RReinosa/RCK/Budget.xlsx

Presupuesto RCK v1.0
Item | Nombre | Tipo | Cantidad (min) | Pack | Precio total | Referencias
Condensadores | C_1206_3216Metric | 0.1uF | 9 | 16 | 3.78 € | https://es.aliexpress.com/item/32785228491.html
 |  | 1uF | 2 | 16
 |  | 10uF | 2 | 16
 |  | 22pF | 4 | 16
Resistencias | R_1206_3216Metric | 22 Ω | 8 | 20 | 4.23 € | https://es.aliexpress.com/item/32774150552.html
 |  | 10k Ω | 4 | 20
 |  | 330 Ω | 2 | 20
Diodos ghosting | D_SOD-123 | 1N4148W | 99 | 100 | 2.88 € | https://es.aliexpress.com/item/1005002887019519.html
Diodos Leds | LED_SK6812_PLCC4_5.0X5.0mm_P3.2mm | SK6812_RBGCW | 99 | 100 | 13.28 € | https://es.aliexpress.com/item/32641663497.html
Tornillos Pad | MountinHole_2.2mm_M2_Pad_Via | M2 | 14 | 14 | 0.52 € | PASTOR
Insertos tornillos | MountinHole_2.2mm_M2_Pad_Via | M2 | 14 | 14 | 0.46 € | PASTOR
USB-C | USB_C_Receptable_HRO_TYPE-C | 31-M-12 | 2 | 2 | 0.37 € | PASTOR
Polyfuse | Fuse_1206_3216Metric | 500mA | 2 | 2 | 0.14 € | PASTOR
Multiplex | CD74HC4067M | SOIC24 | 1 | 1 | 0.67 € | PASTOR
MCU | Atmega | 32U4-AU | 2 | 2 | 16.27 € | https://es.aliexpress.com/item/1005004179459191.html
Cristal | Crystal_SMD_HC49-SD | 16MHz | 2 | 2 | 0.47 € | PASTOR
Switches | Switch MX RGB Black | Gateron | 99 | 110 | 30.14 € | https://es.aliexpress.com/item/32980039972.html
Estabilizadores | EG_GH60 | 2 un. | 4 | 4 | 12.55 € | https://es.aliexpress.com/item/4000268680880.html
 |  | 6,25 un. | 1 | 1
PCB | FR-4_2Layers RCK v0.1 | Blue | 1 | 5 | 6.50 € | https://jlcpcb.com/
 | FR-4_2Layers RCK v1.0 | Blue | 1 | 5 | 38.94 €
Plate |  |  | 1
Caja |  |  | 1
Keycaps |  |  | 99
Cable | Cable en espiral | Black | 1 | 1 | 12.22 € | https://es.aliexpress.com/item/1005004438383771.html
 |  |  |  | Total | 143.42 €
 |  |  |  |  | 143.42 €
