RReinosa/RCK/v1.0/plate/Platecopia.DXF

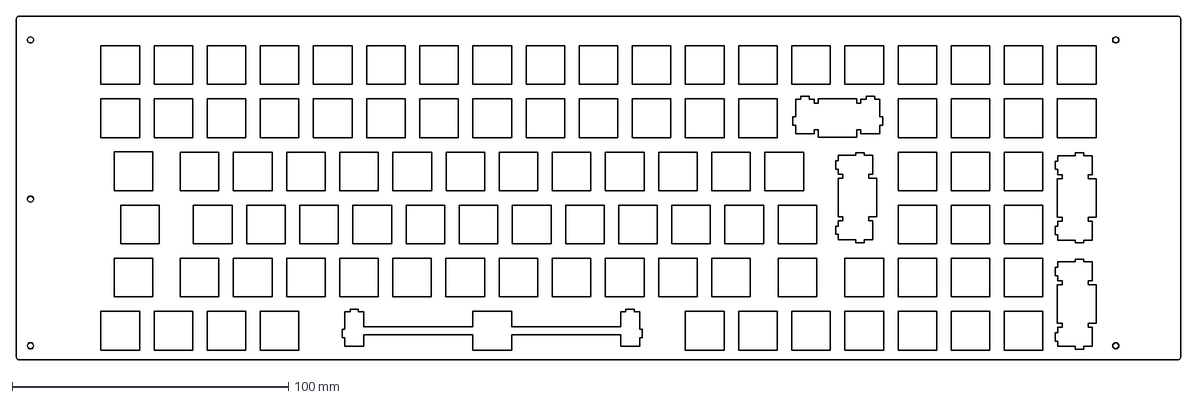
[picture p2: CAD file, 2023-10-01]
v1.0/plate/Platecopia.DXF
421.7 x 124.5 mm
