RReinosa/RCK/v1.0/plate/plate.dxf

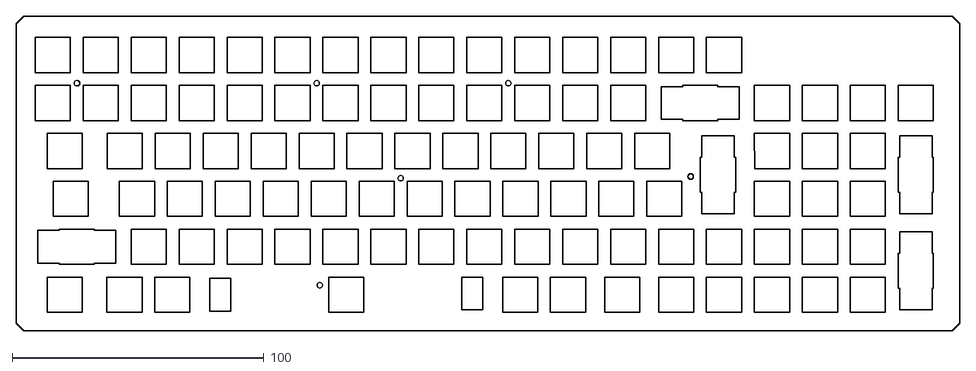
[picture p3: CAD file, 2023-03-14]
v1.0/plate/plate.dxf
375.0 x 125.0
