RReinosa/RCK/(list of files, cad)

Other CAD files:
v1.0/pcb/pcb.dxf
v1.0/plate/plate.dwg
