RReinosa/RCK/v1.0/pcb/pcb_design/pcb.pdf

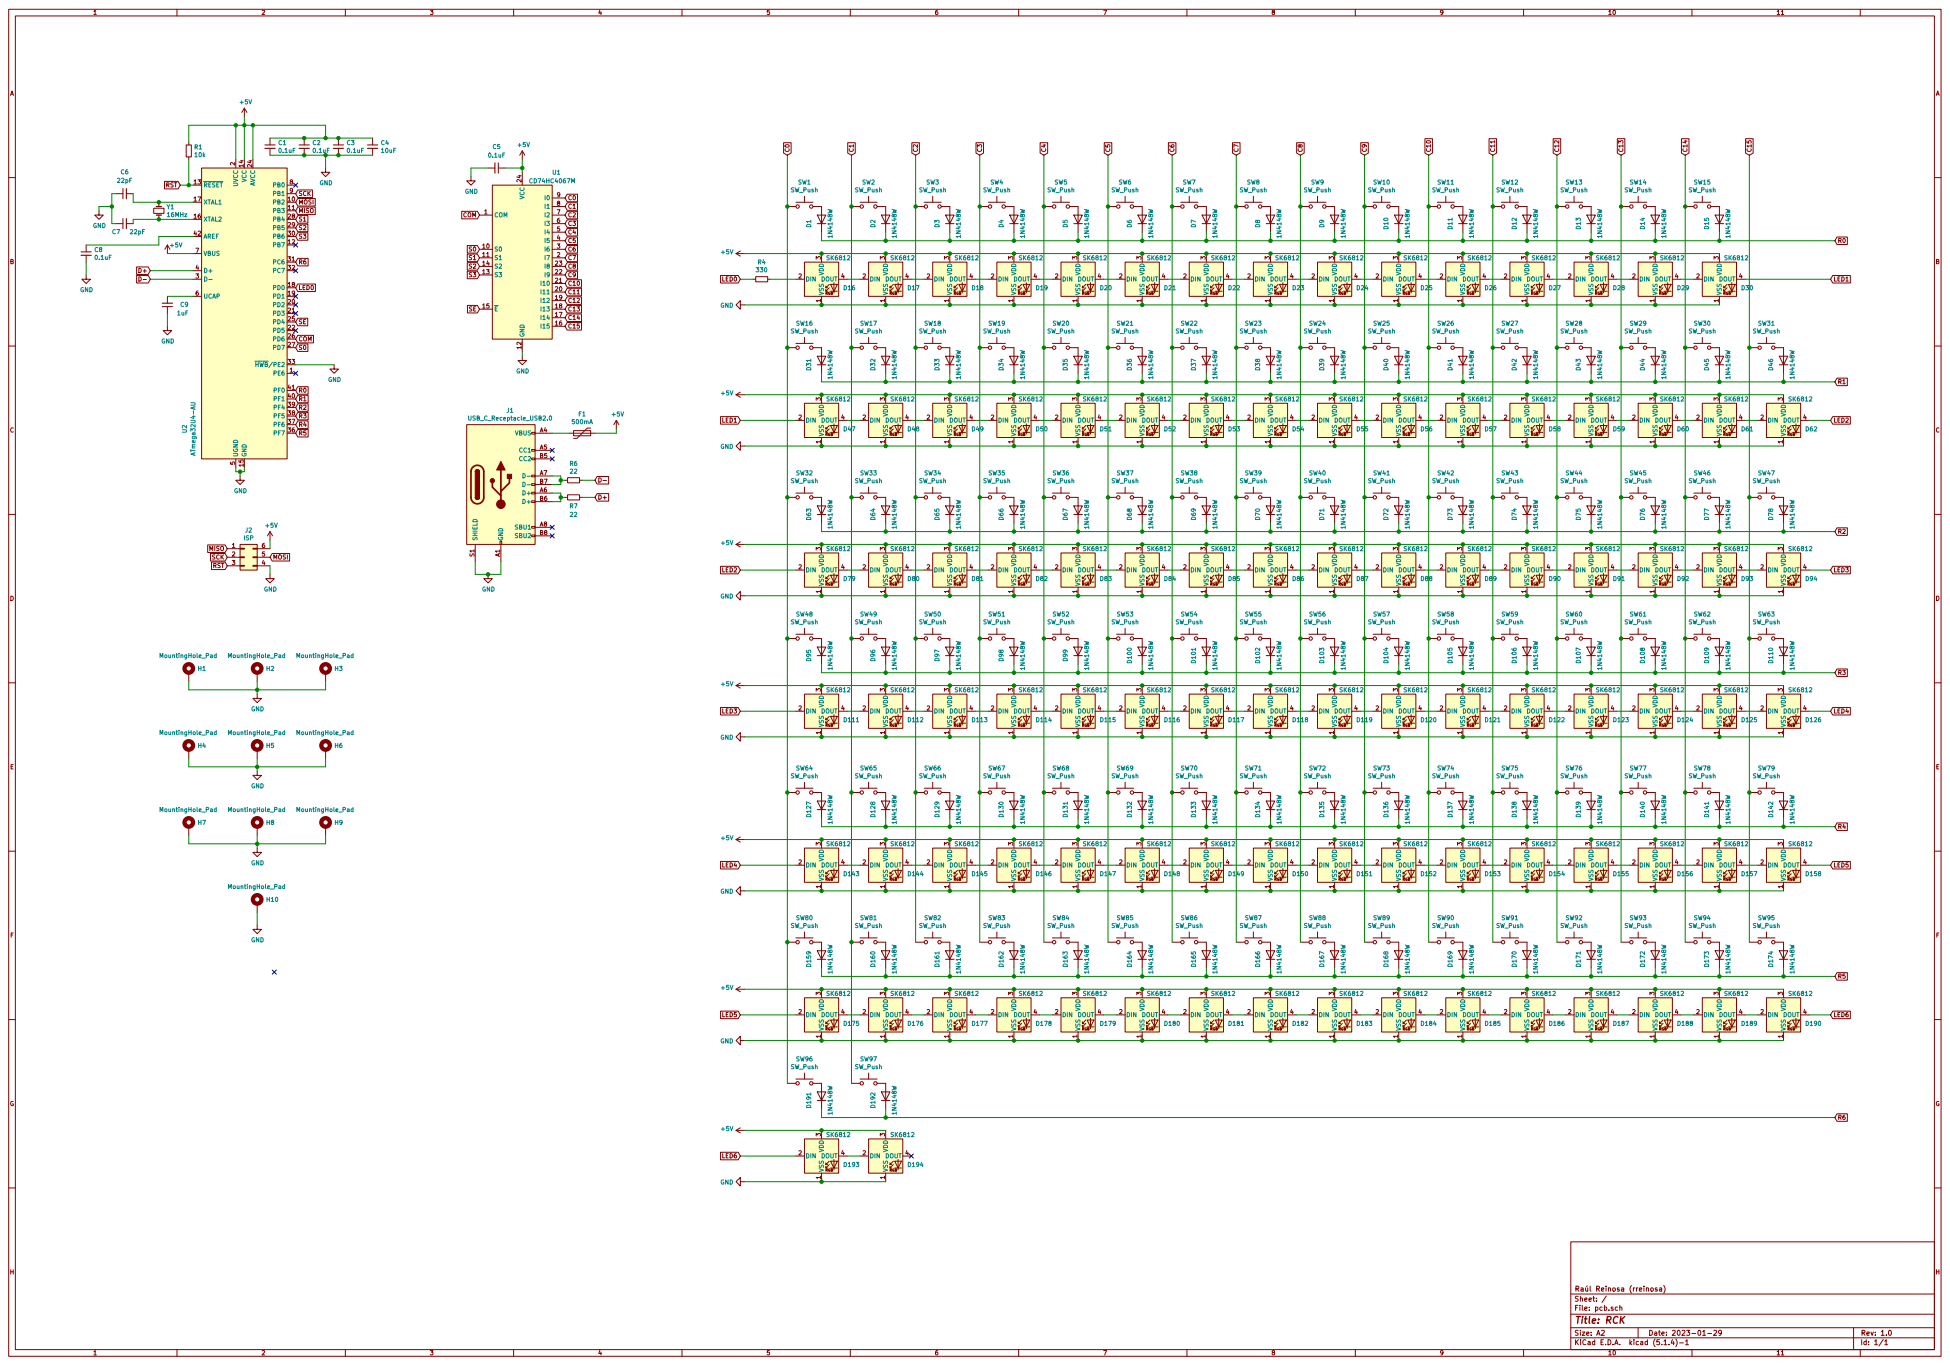
[picture p4: page 1]

2 PD2 20 PD3 21 PD5 22 AVCC 24 PD4 25 PD6 26 PD7 27 PB4 28 PB5 29 D- 3 PB6 30 PC6 31 PC7 32 HWB/PE2 33 PF7 36 PF6 37 PF5 38 PF4 39 D+ 4 PF1 40 PF0 41 AREF 42 UGND

3 DOUT 4D18 SK6812 SW9 SW_Push SW26 SW_Push SW11 SW_Push SW12 SW_Push VSS RGB 1 DIN 2 VDD

3 DOUT 4D20 SK6812 SW6 SW_Push SW7 SW_Push VSS RGB 1 DIN 2 VDD

3 DOUT 4D52 SK6812 H7 MountingHole_Pad VSS RGB 1 DIN

3 DOUT 4D50 SK6812 VSS RGB 1 DIN 2 VDD

3 DOUT 4D51 SK6812 VSS RGB 1 DIN 2 VDD

3 DOUT 4D80 SK6812 VSS RGB 1 DIN 2 VDD

3 DOUT 4D81 SK6812 VSS RGB 1 DIN 2 VDD

3 DOUT 4D82 SK6812 VSS RGB 1 DIN 2 VDD

3 DOUT 4D83 SK6812 VSS RGB 1 DIN 2 VDD

3 DOUT 4D84 SK6812 VSS RGB 1 DIN 2 VDD

3 DOUT 4D112 SK6812 VSS RGB 1 DIN 2 VDD

3 DOUT 4D115 SK6812 VSS RGB 1 DIN 2 VDD

3 DOUT 4D175 SK6812 VSS RGB 1 DIN 2 VDD

3 DOUT 4D176 SK6812 VSS RGB 1 DIN 2 VDD

3 DOUT 4D177 SK6812 VSS RGB 1 DIN 2 VDD

3 DOUT 4D178 SK6812 VSS RGB 1 DIN 2 VDD

3 DOUT 4D179 SK6812 VSS RGB 1 DIN 2 VDD

3 DOUT 4D180 SK6812 VSS RGB 1 DIN
