RReinosa/RCK/v1.0/plate/plate.pdf

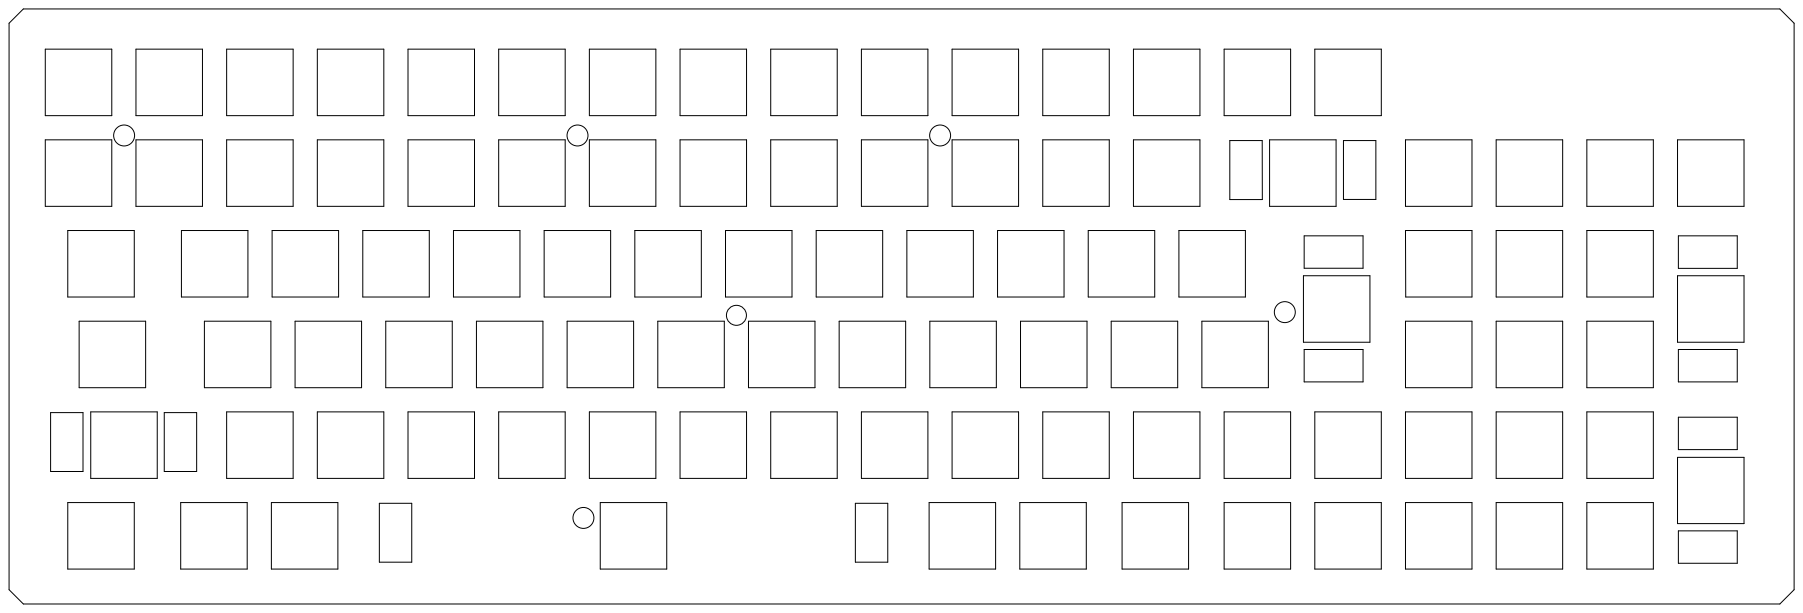
[picture p5: page 1]
