RReinosa/RCK/(list of files, drawings)

Other design files:
v0.1/pcb/pcb.dsn
v1.0/pcb/pcb.dsn
