RReinosa/RCK/v1.0/pcb/pcb.kicad_pcb

## KiCad design v1.0/pcb/pcb.kicad_pcb (2023-10-01)

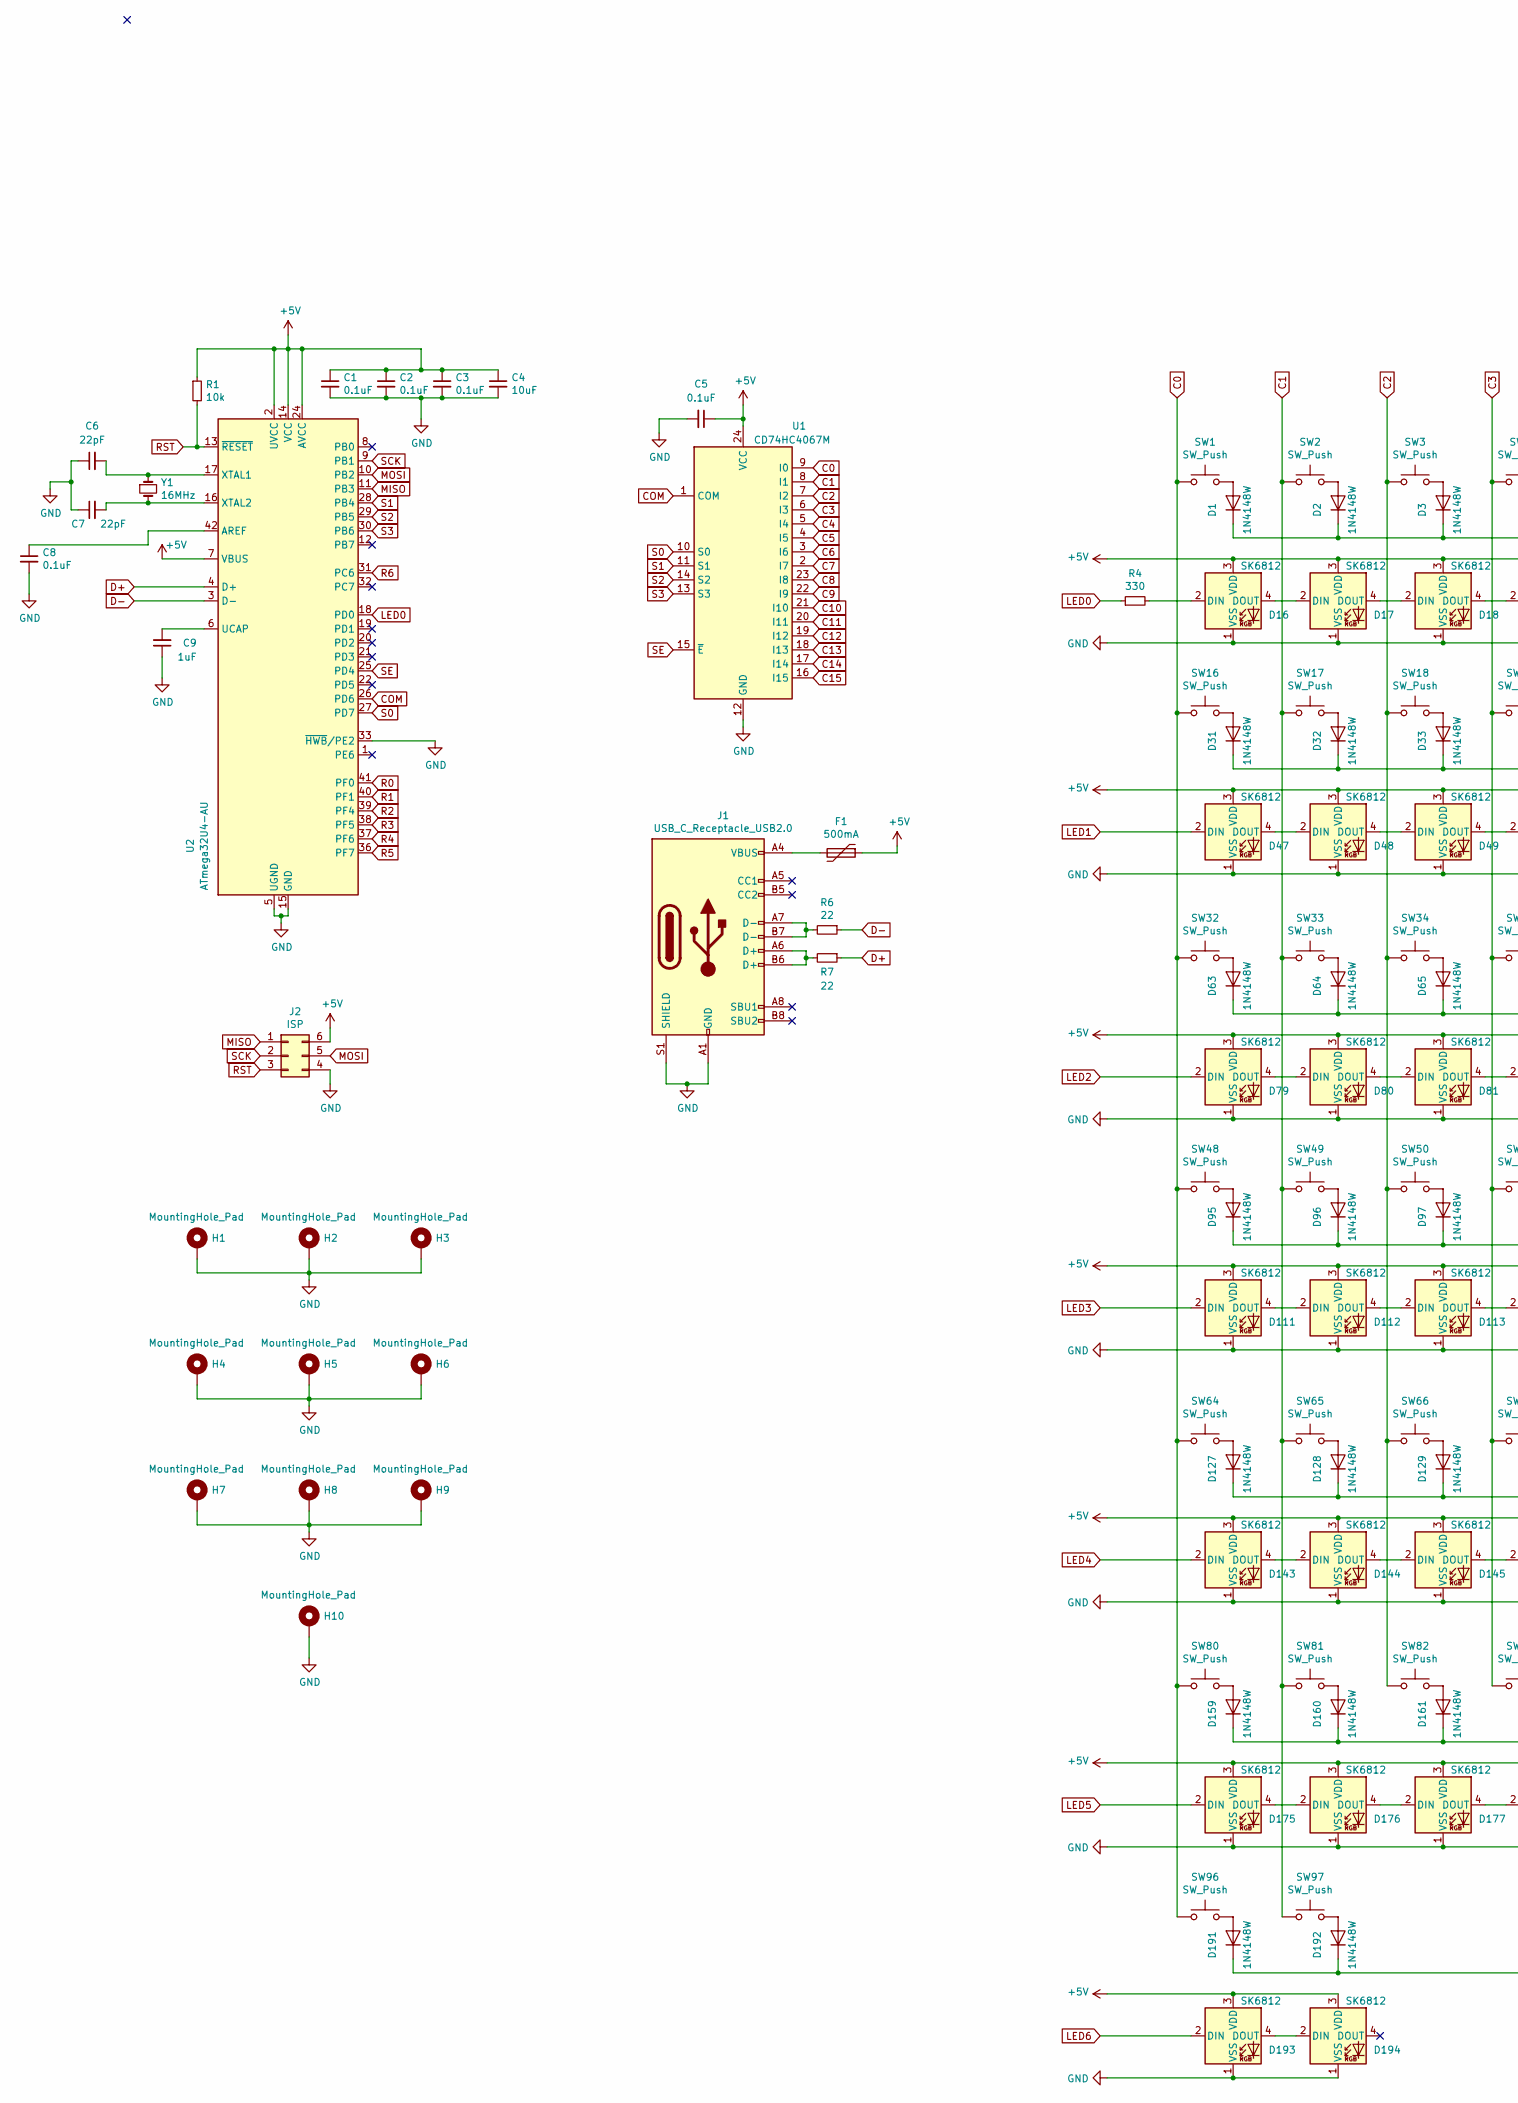
[picture p6: schematic pcb.sch, RCK, part in row 1, column 1]

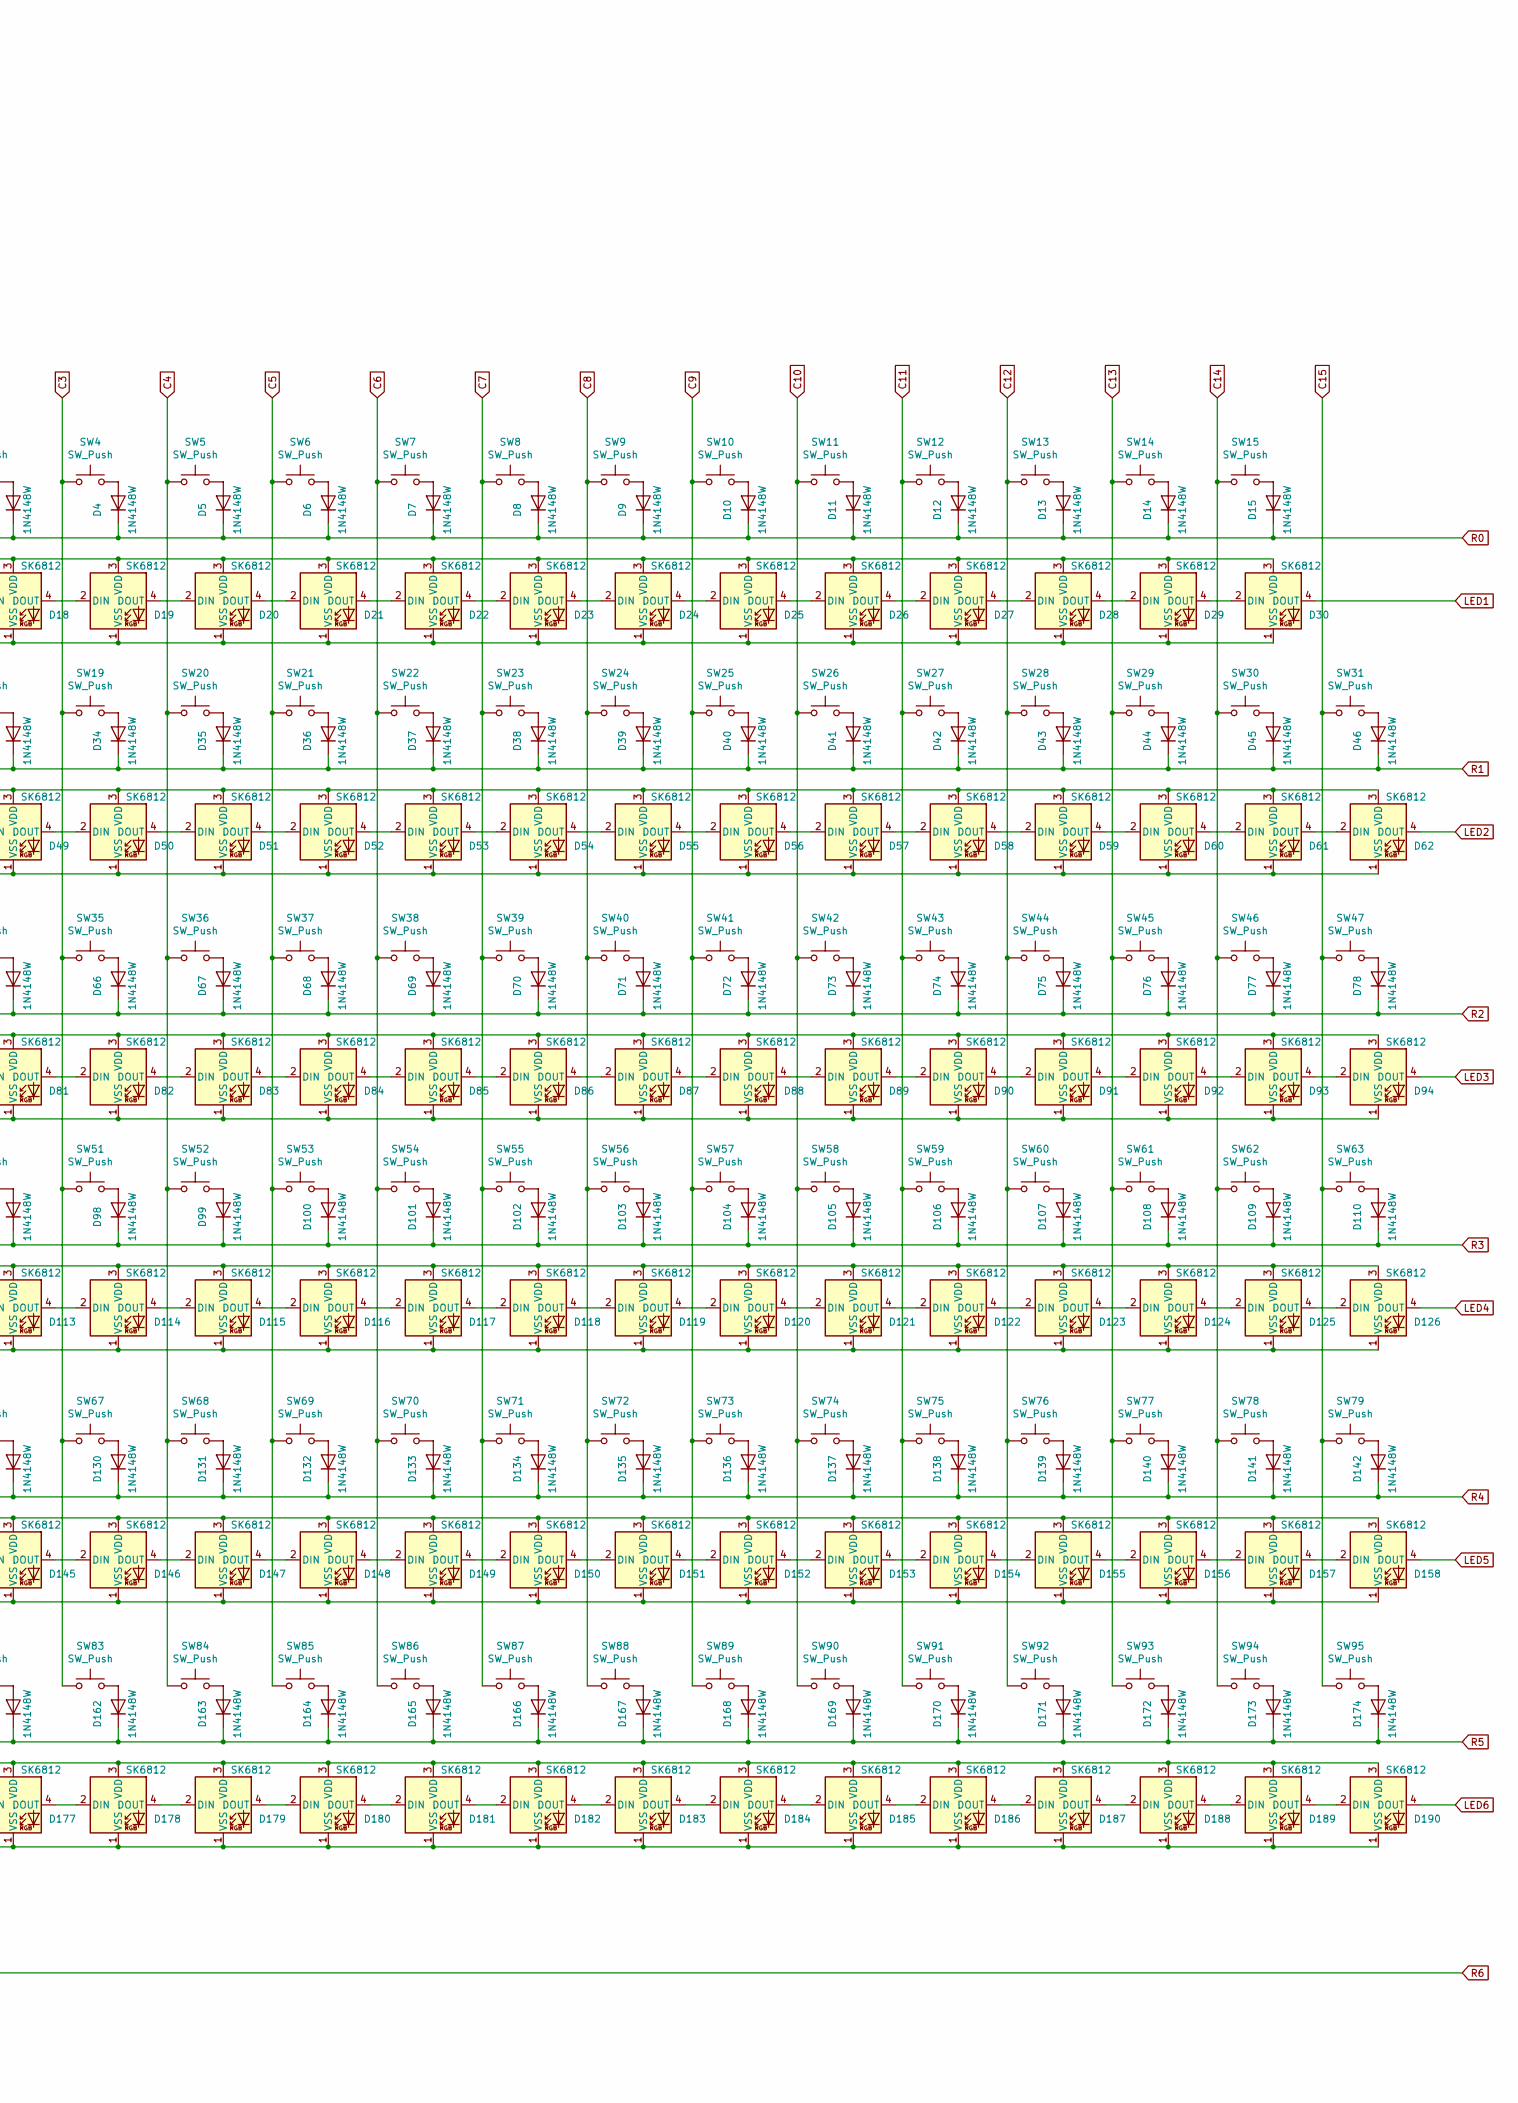
[picture p7: schematic pcb.sch, RCK, part in row 1, column 2]

Parts:
C1, C2, C3, C5, C8: 0.1uF; C_1206_3216Metric
C4: 10uF; C_1206_3216Metric
C6, C7: 22pF; C_1206_3216Metric
C9: 1uF; C_1206_3216Metric
D1, D2, D3, D4, D5, D6, D7, D8, D9, D10, D11, D12, D13, D14, D15, D31, D32, D33, D34, D35, D36, D37, D38, D39, D40, D41, D42, D43, D44, D45, D46, D63, D64, D65, D66, D67, D68, D69, D70, D71, D72, D73, D74, D75, D76, D77, D78, D95, D96, D97, D98, D99, D100, D101, D102, D103, D104, D105, D106, D107, D108, D109, D110, D127, D128, D129, D130, D131, D132, D133, D134, D135, D136, D137, D138, D139, D140, D141, D142, D159, D160, D161, D162, D163, D164, D165, D166, D167, D168, D169, D170, D171, D172, D173, D174, D191, D192: 1N4148W; D_SOD-123
D16, D17, D18, D19, D20, D21, D22, D23, D24, D25, D26, D27, D28, D29, D30, D47, D48, D49, D50, D51, D52, D53, D54, D55, D56, D57, D58, D59, D60, D61, D62, D79, D80, D81, D82, D83, D84, D85, D86, D87, D88, D89, D90, D91, D92, D93, D94, D111, D112, D113, D114, D115, D116, D117, D118, D119, D120, D121, D122, D123, D124, D125, D126, D143, D144, D145, D146, D147, D148, D149, D150, D151, D152, D153, D154, D155, D156, D157, D158, D175, D176, D177, D178, D179, D180, D181, D182, D183, D184, D185, D186, D187, D188, D189, D190, D193, D194: SK6812; LED_SK6812_PLCC4_5.0x5.0mm_P3.2mm
F1: 500mA; Fuse_1206_3216Metric
H1, H2, H3, H4, H5, H6, H7, H8, H9, H10: MountingHole_Pad; MountingHole_2.2mm_M2_Pad_Via
J1: USB_C_Receptacle_USB2.0; USB_C_Receptacle_HRO_TYPE-C-31-M-12
J2: ISP; PinHeader_2x03_P2.54mm_Vertical
R1: 10k; R_1206_3216Metric
R4: 330; R_1206_3216Metric
R6, R7: 22; R_1206_3216Metric
SW1, SW2, SW3, SW4, SW5, SW6, SW7, SW8, SW9, SW10, SW11, SW12, SW13, SW14, SW15, SW16, SW17, SW18, SW19, SW20, SW21, SW22, SW23, SW24, SW25, SW26, SW27, SW28, SW30, SW31, SW32, SW33, SW35, SW36, SW37, SW38, SW39, SW40, SW41, SW42, SW43, SW44, SW45, SW46, SW48, SW49, SW50, SW53, SW54, SW55, SW56, SW57, SW58, SW59, SW60, SW61, SW62, SW63, SW64, SW65, SW66, SW67, SW69, SW70, SW71, SW72, SW73, SW74, SW75, SW76, SW77, SW78, SW79, SW80, SW81, SW82, SW83, SW84, SW87, SW88, SW90, SW91, SW93, SW94, SW95, SW96, SW97: SW_Push; SW_Cherry_MX_1.00u_Plate
SW29, SW68: SW_Push; SW_Cherry_MX_2.00u_PCB
SW34, SW86: SW_Push; SW_Cherry_MX_1.50u_Plate
SW47: SW_Push; SW_Cherry_MX_ISOEnter_PCB
SW51, SW85: SW_Push; SW_Cherry_MX_2.00u_Vertical_PCB
SW52: SW_Push; SW_Cherry_MX_1.75u_Plate
SW89: SW_Push; SW_Cherry_MX_6.25u_PCB
SW92: SW_Push; SW_Cherry_MX_1.25u_Plate
U1: CD74HC4067M; SOIC-24W_7.5x15.4mm_P1.27mm
U2: ATmega32U4-AU; TQFP-44_10x10mm_P0.8mm
Y1: 16MHz; Crystal_SMD_HC49-SD

Connections:
+5V: C1.1, C2.1, C3.1, C4.1, C5.1, D16.3 (VDD), D17.3 (VDD), D18.3 (VDD), D19.3 (VDD), D20.3 (VDD), D21.3 (VDD), D22.3 (VDD), D23.3 (VDD), D24.3 (VDD), D25.3 (VDD), D26.3 (VDD), D27.3 (VDD), D28.3 (VDD), D29.3 (VDD), D30.3 (VDD), D47.3 (VDD), D48.3 (VDD), D49.3 (VDD), D50.3 (VDD), D51.3 (VDD), D52.3 (VDD), D53.3 (VDD), D54.3 (VDD), D55.3 (VDD), D56.3 (VDD), D57.3 (VDD), D58.3 (VDD), D59.3 (VDD), D60.3 (VDD), D61.3 (VDD), D62.3 (VDD), D79.3 (VDD), D80.3 (VDD), D81.3 (VDD), D82.3 (VDD), D83.3 (VDD), D84.3 (VDD), D85.3 (VDD), D86.3 (VDD), D87.3 (VDD), D88.3 (VDD), D89.3 (VDD), D90.3 (VDD), D91.3 (VDD), D92.3 (VDD), D93.3 (VDD), D94.3 (VDD), D111.3 (VDD), D112.3 (VDD), D113.3 (VDD), D114.3 (VDD), D115.3 (VDD), D116.3 (VDD), D117.3 (VDD), D118.3 (VDD), D119.3 (VDD), D120.3 (VDD), D121.3 (VDD), D122.3 (VDD), D123.3 (VDD), D124.3 (VDD), D125.3 (VDD), D126.3 (VDD), D143.3 (VDD), D144.3 (VDD), D145.3 (VDD), D146.3 (VDD), D147.3 (VDD), D148.3 (VDD), D149.3 (VDD), D150.3 (VDD), D151.3 (VDD), D152.3 (VDD), D153.3 (VDD), D154.3 (VDD), D155.3 (VDD), D156.3 (VDD), D157.3 (VDD), D158.3 (VDD), D175.3 (VDD), D176.3 (VDD), D177.3 (VDD), D178.3 (VDD), D179.3 (VDD), D180.3 (VDD), D181.3 (VDD), D182.3 (VDD), D183.3 (VDD), D184.3 (VDD), D185.3 (VDD), D186.3 (VDD), D187.3 (VDD), D188.3 (VDD), D189.3 (VDD), D190.3 (VDD), D193.3 (VDD), D194.3 (VDD), F1.1, J2.6, R1.1, U1.24 (VCC), U2.2 (UVCC), U2.7 (VBUS), U2.14 (VCC), U2.24 (AVCC), U2.34 (VCC), U2.44 (AVCC)
C0: SW1.1, SW16.1, SW32.1, SW48.1, SW64.1, SW80.1, SW96.1, U1.9 (I0)
C1: SW2.1, SW17.1, SW33.1, SW49.1, SW65.1, SW81.1, SW97.1, U1.8 (I1)
C2: SW3.1, SW18.1, SW34.1, SW50.1, SW66.1, SW82.1, U1.7 (I2)
C3: SW4.1, SW19.1, SW35.1, SW51.1, SW67.1, SW83.1, U1.6 (I3)
C4: SW5.1, SW20.1, SW36.1, SW52.1, SW68.1, SW84.1, U1.5 (I4)
C5: SW6.1, SW21.1, SW37.1, SW53.1, SW69.1, SW85.1, U1.4 (I5)
C6: SW7.1, SW22.1, SW38.1, SW54.1, SW70.1, SW86.1, U1.3 (I6)
C7: SW8.1, SW23.1, SW39.1, SW55.1, SW71.1, SW87.1, U1.2 (I7)
C8: SW9.1, SW24.1, SW40.1, SW56.1, SW72.1, SW88.1, U1.23 (I8)
C9: SW10.1, SW25.1, SW41.1, SW57.1, SW73.1, SW89.1, U1.22 (I9)
C10: SW11.1, SW26.1, SW42.1, SW58.1, SW74.1, SW90.1, U1.21 (I10)
C11: SW12.1, SW27.1, SW43.1, SW59.1, SW75.1, SW91.1, U1.20 (I11)
C12: SW13.1, SW28.1, SW44.1, SW60.1, SW76.1, SW92.1, U1.19 (I12)
C13: SW14.1, SW29.1, SW45.1, SW61.1, SW77.1, SW93.1, U1.18 (I13)
C14: SW15.1, SW30.1, SW46.1, SW62.1, SW78.1, SW94.1, U1.17 (I14)
C15: SW31.1, SW47.1, SW63.1, SW79.1, SW95.1, U1.16 (I15)
COM: U1.1 (COM), U2.26 (PD6)
D+: R7.1, U2.4 (D+)
D-: R6.1, U2.3 (D-)
GND: C1.2, C2.2, C3.2, C4.2, C5.2, C6.1, C7.1, C8.2, C9.1, D16.1 (VSS), D17.1 (VSS), D18.1 (VSS), D19.1 (VSS), D20.1 (VSS), D21.1 (VSS), D22.1 (VSS), D23.1 (VSS), D24.1 (VSS), D25.1 (VSS), D26.1 (VSS), D27.1 (VSS), D28.1 (VSS), D29.1 (VSS), D30.1 (VSS), D47.1 (VSS), D48.1 (VSS), D49.1 (VSS), D50.1 (VSS), D51.1 (VSS), D52.1 (VSS), D53.1 (VSS), D54.1 (VSS), D55.1 (VSS), D56.1 (VSS), D57.1 (VSS), D58.1 (VSS), D59.1 (VSS), D60.1 (VSS), D61.1 (VSS), D62.1 (VSS), D79.1 (VSS), D80.1 (VSS), D81.1 (VSS), D82.1 (VSS), D83.1 (VSS), D84.1 (VSS), D85.1 (VSS), D86.1 (VSS), D87.1 (VSS), D88.1 (VSS), D89.1 (VSS), D90.1 (VSS), D91.1 (VSS), D92.1 (VSS), D93.1 (VSS), D94.1 (VSS), D111.1 (VSS), D112.1 (VSS), D113.1 (VSS), D114.1 (VSS), D115.1 (VSS), D116.1 (VSS), D117.1 (VSS), D118.1 (VSS), D119.1 (VSS), D120.1 (VSS), D121.1 (VSS), D122.1 (VSS), D123.1 (VSS), D124.1 (VSS), D125.1 (VSS), D126.1 (VSS), D143.1 (VSS), D144.1 (VSS), D145.1 (VSS), D146.1 (VSS), D147.1 (VSS), D148.1 (VSS), D149.1 (VSS), D150.1 (VSS), D151.1 (VSS), D152.1 (VSS), D153.1 (VSS), D154.1 (VSS), D155.1 (VSS), D156.1 (VSS), D157.1 (VSS), D158.1 (VSS), D175.1 (VSS), D176.1 (VSS), D177.1 (VSS), D178.1 (VSS), D179.1 (VSS), D180.1 (VSS), D181.1 (VSS), D182.1 (VSS), D183.1 (VSS), D184.1 (VSS), D185.1 (VSS), D186.1 (VSS), D187.1 (VSS), D188.1 (VSS), D189.1 (VSS), D190.1 (VSS), D193.1 (VSS), D194.1 (VSS), H1.1, H2.1, H3.1, H4.1, H5.1, H6.1, H7.1, H8.1, H9.1, H10.1, J1.A1 (GND), J1.A12 (GND), J1.B1 (GND), J1.B12 (GND), J1.S1 (SHIELD), J2.4, U1.12 (GND), U2.5 (UGND), U2.15 (GND), U2.23 (GND), U2.33 (~HWB~/PE2), U2.35 (GND), U2.43 (GND)
LED0: R4.1, U2.18 (PD0)
LED1: D30.4 (DOUT), D47.2 (DIN)
LED2: D62.4 (DOUT), D79.2 (DIN)
LED3: D94.4 (DOUT), D111.2 (DIN)
LED4: D126.4 (DOUT), D143.2 (DIN)
LED5: D158.4 (DOUT), D175.2 (DIN)
LED6: D190.4 (DOUT), D193.2 (DIN)
MISO: J2.1, U2.11 (PB3)
MOSI: J2.5, U2.10 (PB2)
unnamed: C6.2, U2.17 (XTAL1), Y1.1
unnamed: C7.2, U2.16 (XTAL2), Y1.2
unnamed: C8.1, U2.42 (AREF)
unnamed: C9.2, U2.6 (UCAP)
unnamed: D1.2 (A), SW1.2
unnamed: D2.2 (A), SW2.2
unnamed: D3.2 (A), SW3.2
unnamed: D4.2 (A), SW4.2
unnamed: D5.2 (A), SW5.2
unnamed: D6.2 (A), SW6.2
unnamed: D7.2 (A), SW7.2
unnamed: D8.2 (A), SW8.2
unnamed: D9.2 (A), SW9.2
unnamed: D10.2 (A), SW10.2
unnamed: D11.2 (A), SW11.2
unnamed: D12.2 (A), SW12.2
unnamed: D13.2 (A), SW13.2
unnamed: D14.2 (A), SW14.2
unnamed: D15.2 (A), SW15.2
unnamed: D16.2 (DIN), R4.2
unnamed: D16.4 (DOUT), D17.2 (DIN)
unnamed: D17.4 (DOUT), D18.2 (DIN)
unnamed: D18.4 (DOUT), D19.2 (DIN)
unnamed: D19.4 (DOUT), D20.2 (DIN)
unnamed: D20.4 (DOUT), D21.2 (DIN)
unnamed: D21.4 (DOUT), D22.2 (DIN)
unnamed: D22.4 (DOUT), D23.2 (DIN)
unnamed: D23.4 (DOUT), D24.2 (DIN)
unnamed: D24.4 (DOUT), D25.2 (DIN)
unnamed: D25.4 (DOUT), D26.2 (DIN)
unnamed: D26.4 (DOUT), D27.2 (DIN)
unnamed: D27.4 (DOUT), D28.2 (DIN)
unnamed: D28.4 (DOUT), D29.2 (DIN)
unnamed: D29.4 (DOUT), D30.2 (DIN)
unnamed: D31.2 (A), SW16.2
unnamed: D32.2 (A), SW17.2
unnamed: D33.2 (A), SW18.2
unnamed: D34.2 (A), SW19.2
unnamed: D35.2 (A), SW20.2
unnamed: D36.2 (A), SW21.2
unnamed: D37.2 (A), SW22.2
unnamed: D38.2 (A), SW23.2
unnamed: D39.2 (A), SW24.2
unnamed: D40.2 (A), SW25.2
unnamed: D41.2 (A), SW26.2
unnamed: D42.2 (A), SW27.2
unnamed: D43.2 (A), SW28.2
unnamed: D44.2 (A), SW29.2
unnamed: D45.2 (A), SW30.2
unnamed: D46.2 (A), SW31.2
unnamed: D47.4 (DOUT), D48.2 (DIN)
unnamed: D48.4 (DOUT), D49.2 (DIN)
unnamed: D49.4 (DOUT), D50.2 (DIN)
unnamed: D50.4 (DOUT), D51.2 (DIN)
unnamed: D51.4 (DOUT), D52.2 (DIN)
unnamed: D52.4 (DOUT), D53.2 (DIN)
unnamed: D53.4 (DOUT), D54.2 (DIN)
unnamed: D54.4 (DOUT), D55.2 (DIN)
unnamed: D55.4 (DOUT), D56.2 (DIN)
unnamed: D56.4 (DOUT), D57.2 (DIN)
unnamed: D57.4 (DOUT), D58.2 (DIN)
unnamed: D58.4 (DOUT), D59.2 (DIN)
unnamed: D59.4 (DOUT), D60.2 (DIN)
unnamed: D60.4 (DOUT), D61.2 (DIN)
unnamed: D61.4 (DOUT), D62.2 (DIN)
unnamed: D63.2 (A), SW32.2
unnamed: D64.2 (A), SW33.2
unnamed: D65.2 (A), SW34.2
unnamed: D66.2 (A), SW35.2
unnamed: D67.2 (A), SW36.2
unnamed: D68.2 (A), SW37.2
unnamed: D69.2 (A), SW38.2
unnamed: D70.2 (A), SW39.2
unnamed: D71.2 (A), SW40.2
unnamed: D72.2 (A), SW41.2
unnamed: D73.2 (A), SW42.2
unnamed: D74.2 (A), SW43.2
unnamed: D75.2 (A), SW44.2
unnamed: D76.2 (A), SW45.2
unnamed: D77.2 (A), SW46.2
unnamed: D78.2 (A), SW47.2
unnamed: D79.4 (DOUT), D80.2 (DIN)
unnamed: D80.4 (DOUT), D81.2 (DIN)
unnamed: D81.4 (DOUT), D82.2 (DIN)
unnamed: D82.4 (DOUT), D83.2 (DIN)
unnamed: D83.4 (DOUT), D84.2 (DIN)
unnamed: D84.4 (DOUT), D85.2 (DIN)
unnamed: D85.4 (DOUT), D86.2 (DIN)
unnamed: D86.4 (DOUT), D87.2 (DIN)
unnamed: D87.4 (DOUT), D88.2 (DIN)
unnamed: D88.4 (DOUT), D89.2 (DIN)
unnamed: D89.4 (DOUT), D90.2 (DIN)
unnamed: D90.4 (DOUT), D91.2 (DIN)
unnamed: D91.4 (DOUT), D92.2 (DIN)
unnamed: D92.4 (DOUT), D93.2 (DIN)
unnamed: D93.4 (DOUT), D94.2 (DIN)
unnamed: D95.2 (A), SW48.2
unnamed: D96.2 (A), SW49.2
unnamed: D97.2 (A), SW50.2
unnamed: D98.2 (A), SW51.2
unnamed: D99.2 (A), SW52.2
unnamed: D100.2 (A), SW53.2
unnamed: D101.2 (A), SW54.2
unnamed: D102.2 (A), SW55.2
unnamed: D103.2 (A), SW56.2
unnamed: D104.2 (A), SW57.2
unnamed: D105.2 (A), SW58.2
unnamed: D106.2 (A), SW59.2
unnamed: D107.2 (A), SW60.2
unnamed: D108.2 (A), SW61.2
unnamed: D109.2 (A), SW62.2
unnamed: D110.2 (A), SW63.2
unnamed: D111.4 (DOUT), D112.2 (DIN)
unnamed: D112.4 (DOUT), D113.2 (DIN)
unnamed: D113.4 (DOUT), D114.2 (DIN)
unnamed: D114.4 (DOUT), D115.2 (DIN)
unnamed: D115.4 (DOUT), D116.2 (DIN)
unnamed: D116.4 (DOUT), D117.2 (DIN)
unnamed: D117.4 (DOUT), D118.2 (DIN)
unnamed: D118.4 (DOUT), D119.2 (DIN)
unnamed: D119.4 (DOUT), D120.2 (DIN)
unnamed: D120.4 (DOUT), D121.2 (DIN)
unnamed: D121.4 (DOUT), D122.2 (DIN)
unnamed: D122.4 (DOUT), D123.2 (DIN)
unnamed: D123.4 (DOUT), D124.2 (DIN)
unnamed: D124.4 (DOUT), D125.2 (DIN)
unnamed: D125.4 (DOUT), D126.2 (DIN)
unnamed: D127.2 (A), SW64.2
unnamed: D128.2 (A), SW65.2
unnamed: D129.2 (A), SW66.2
unnamed: D130.2 (A), SW67.2
unnamed: D131.2 (A), SW68.2
unnamed: D132.2 (A), SW69.2
unnamed: D133.2 (A), SW70.2
unnamed: D134.2 (A), SW71.2
unnamed: D135.2 (A), SW72.2
unnamed: D136.2 (A), SW73.2
unnamed: D137.2 (A), SW74.2
unnamed: D138.2 (A), SW75.2
unnamed: D139.2 (A), SW76.2
unnamed: D140.2 (A), SW77.2
unnamed: D141.2 (A), SW78.2
unnamed: D142.2 (A), SW79.2
unnamed: D143.4 (DOUT), D144.2 (DIN)
unnamed: D144.4 (DOUT), D145.2 (DIN)
unnamed: D145.4 (DOUT), D146.2 (DIN)
unnamed: D146.4 (DOUT), D147.2 (DIN)
unnamed: D147.4 (DOUT), D148.2 (DIN)
unnamed: D148.4 (DOUT), D149.2 (DIN)
unnamed: D149.4 (DOUT), D150.2 (DIN)
unnamed: D150.4 (DOUT), D151.2 (DIN)
unnamed: D151.4 (DOUT), D152.2 (DIN)
unnamed: D152.4 (DOUT), D153.2 (DIN)
unnamed: D153.4 (DOUT), D154.2 (DIN)
unnamed: D154.4 (DOUT), D155.2 (DIN)
unnamed: D155.4 (DOUT), D156.2 (DIN)
unnamed: D156.4 (DOUT), D157.2 (DIN)
unnamed: D157.4 (DOUT), D158.2 (DIN)
unnamed: D159.2 (A), SW80.2
unnamed: D160.2 (A), SW81.2
unnamed: D161.2 (A), SW82.2
unnamed: D162.2 (A), SW83.2
unnamed: D163.2 (A), SW84.2
unnamed: D164.2 (A), SW85.2
unnamed: D165.2 (A), SW86.2
unnamed: D166.2 (A), SW87.2
unnamed: D167.2 (A), SW88.2
unnamed: D168.2 (A), SW89.2
unnamed: D169.2 (A), SW90.2
unnamed: D170.2 (A), SW91.2
unnamed: D171.2 (A), SW92.2
unnamed: D172.2 (A), SW93.2
unnamed: D173.2 (A), SW94.2
unnamed: D174.2 (A), SW95.2
unnamed: D175.4 (DOUT), D176.2 (DIN)
unnamed: D176.4 (DOUT), D177.2 (DIN)
unnamed: D177.4 (DOUT), D178.2 (DIN)
unnamed: D178.4 (DOUT), D179.2 (DIN)
unnamed: D179.4 (DOUT), D180.2 (DIN)
unnamed: D180.4 (DOUT), D181.2 (DIN)
unnamed: D181.4 (DOUT), D182.2 (DIN)
unnamed: D182.4 (DOUT), D183.2 (DIN)
unnamed: D183.4 (DOUT), D184.2 (DIN)
unnamed: D184.4 (DOUT), D185.2 (DIN)
unnamed: D185.4 (DOUT), D186.2 (DIN)
unnamed: D186.4 (DOUT), D187.2 (DIN)
unnamed: D187.4 (DOUT), D188.2 (DIN)
unnamed: D188.4 (DOUT), D189.2 (DIN)
unnamed: D189.4 (DOUT), D190.2 (DIN)
unnamed: D191.2 (A), SW96.2
unnamed: D192.2 (A), SW97.2
unnamed: D193.4 (DOUT), D194.2 (DIN)
unnamed: F1.2, J1.A4 (VBUS), J1.A9 (VBUS), J1.B4 (VBUS), J1.B9 (VBUS)
unnamed: J1.A6 (D+), J1.B6 (D+), R7.2
unnamed: J1.A7 (D-), J1.B7 (D-), R6.2
R0: D1.1 (K), D2.1 (K), D3.1 (K), D4.1 (K), D5.1 (K), D6.1 (K), D7.1 (K), D8.1 (K), D9.1 (K), D10.1 (K), D11.1 (K), D12.1 (K), D13.1 (K), D14.1 (K), D15.1 (K), U2.41 (PF0)
R1: D31.1 (K), D32.1 (K), D33.1 (K), D34.1 (K), D35.1 (K), D36.1 (K), D37.1 (K), D38.1 (K), D39.1 (K), D40.1 (K), D41.1 (K), D42.1 (K), D43.1 (K), D44.1 (K), D45.1 (K), D46.1 (K), U2.40 (PF1)
R2: D63.1 (K), D64.1 (K), D65.1 (K), D66.1 (K), D67.1 (K), D68.1 (K), D69.1 (K), D70.1 (K), D71.1 (K), D72.1 (K), D73.1 (K), D74.1 (K), D75.1 (K), D76.1 (K), D77.1 (K), D78.1 (K), U2.39 (PF4)
R3: D95.1 (K), D96.1 (K), D97.1 (K), D98.1 (K), D99.1 (K), D100.1 (K), D101.1 (K), D102.1 (K), D103.1 (K), D104.1 (K), D105.1 (K), D106.1 (K), D107.1 (K), D108.1 (K), D109.1 (K), D110.1 (K), U2.38 (PF5)
R4: D127.1 (K), D128.1 (K), D129.1 (K), D130.1 (K), D131.1 (K), D132.1 (K), D133.1 (K), D134.1 (K), D135.1 (K), D136.1 (K), D137.1 (K), D138.1 (K), D139.1 (K), D140.1 (K), D141.1 (K), D142.1 (K), U2.37 (PF6)
R5: D159.1 (K), D160.1 (K), D161.1 (K), D162.1 (K), D163.1 (K), D164.1 (K), D165.1 (K), D166.1 (K), D167.1 (K), D168.1 (K), D169.1 (K), D170.1 (K), D171.1 (K), D172.1 (K), D173.1 (K), D174.1 (K), U2.36 (PF7)
R6: D191.1 (K), D192.1 (K), U2.31 (PC6)
RST: J2.3, R1.2, U2.13 (~RESET)
S0: U1.10 (S0), U2.27 (PD7)
S1: U1.11 (S1), U2.28 (PB4)
S2: U1.14 (S2), U2.29 (PB5)
S3: U1.13 (S3), U2.30 (PB6)
SCK: J2.2, U2.9 (PB1)
SE: U1.15 (~E), U2.25 (PD4)

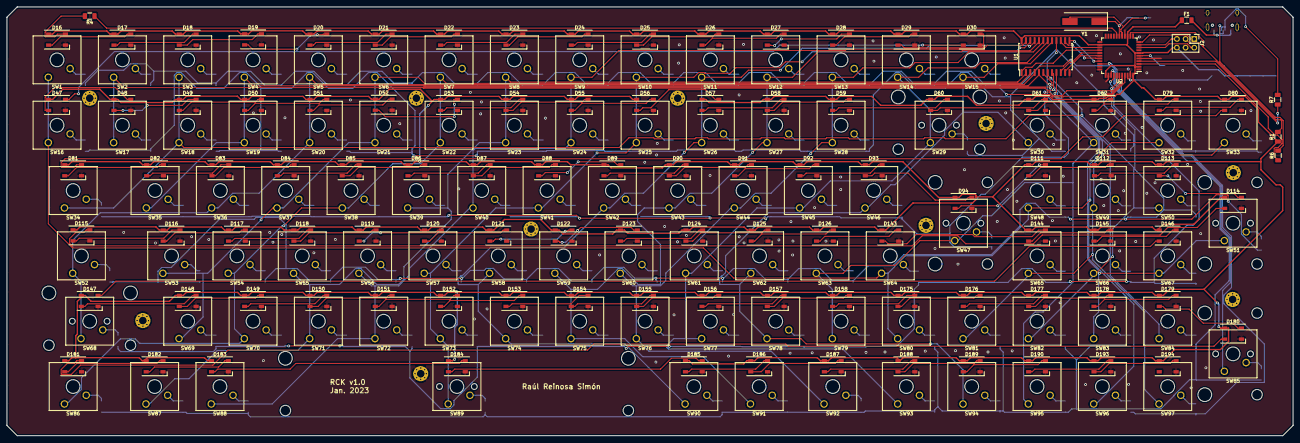
[picture p8: board v1.0/pcb/pcb.kicad_pcb from above]

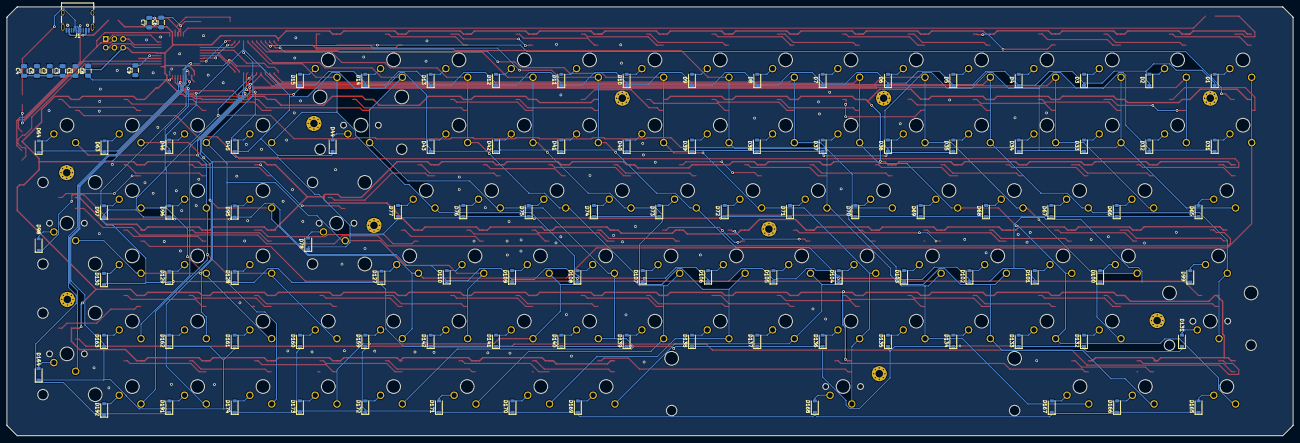
[picture p9: board v1.0/pcb/pcb.kicad_pcb from below]

Board: 2 copper layers, 375.0 x 125.0 mm, 320 parts (107 on the bottom side), 239 nets.
