RReinosa/RCK/v0.1/pcb/pcb.kicad_pcb

## KiCad design v0.1/pcb/pcb.kicad_pcb (2023-02-23, an earlier design)

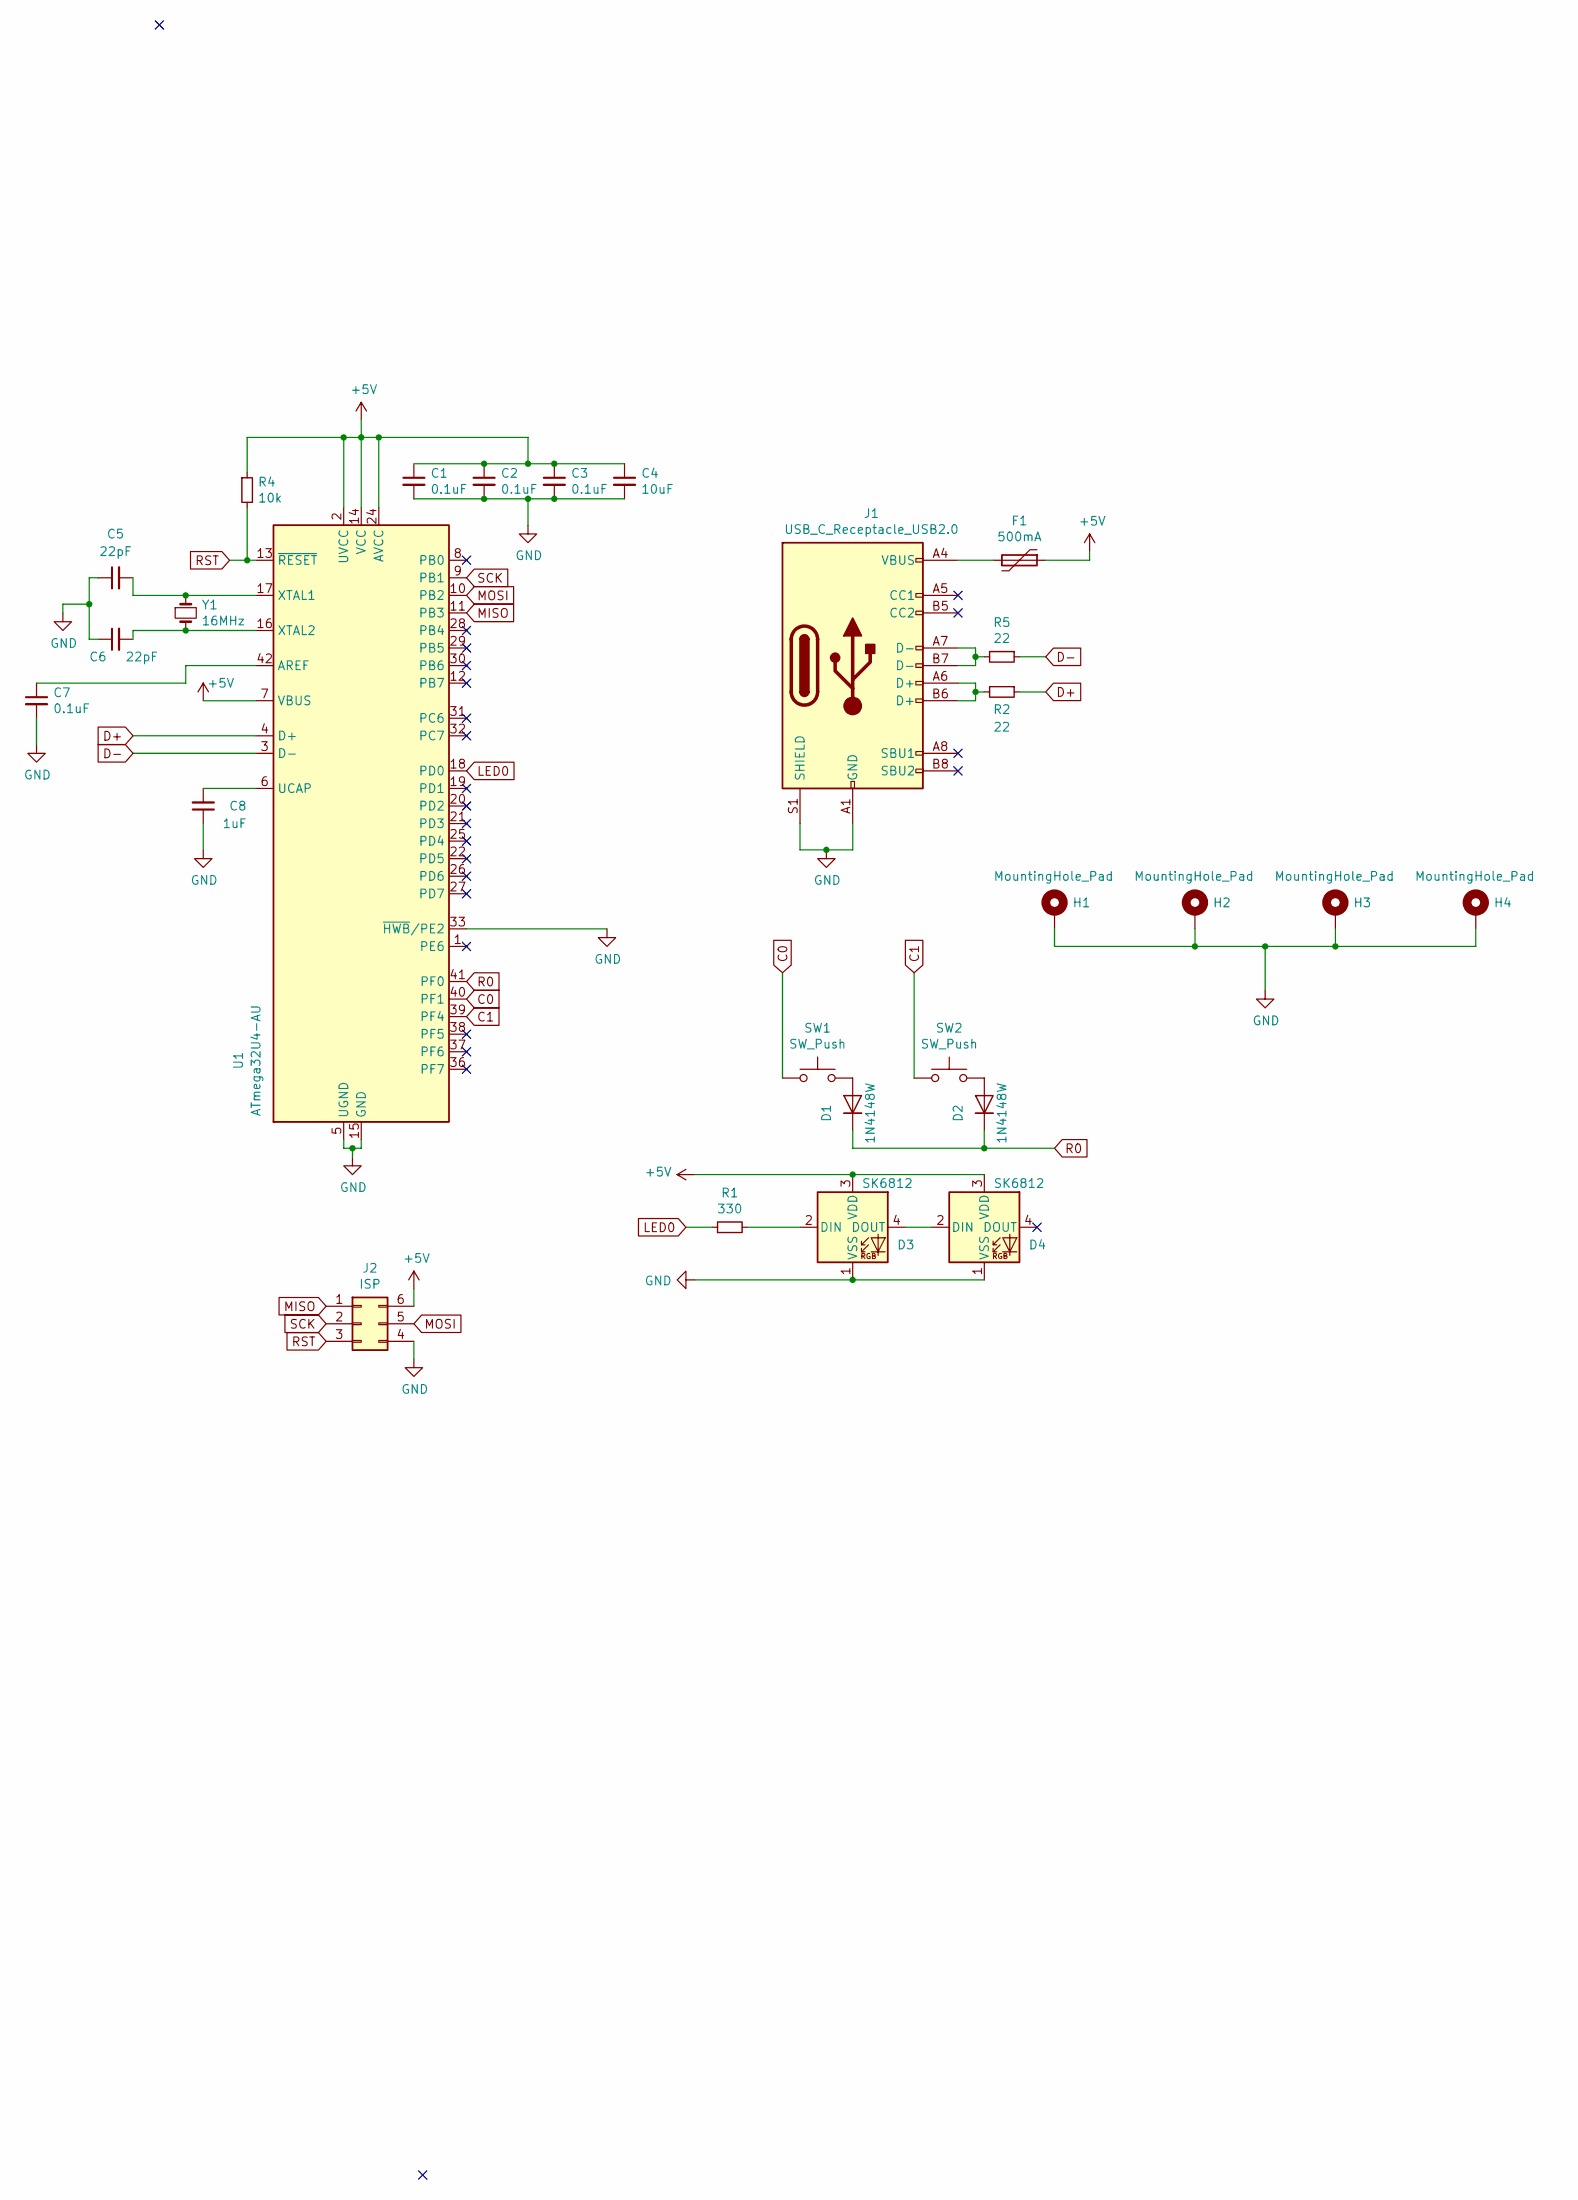
[picture p10: schematic pcb.sch, RCK]

Parts:
C1, C2, C3, C7: 0.1uF; C_1206_3216Metric
C4: 10uF; C_1206_3216Metric
C5, C6: 22pF; C_1206_3216Metric
C8: 1uF; C_1206_3216Metric
D1, D2: 1N4148W; D_SOD-123
D3, D4: SK6812; LED_SK6812_PLCC4_5.0x5.0mm_P3.2mm
F1: 500mA; Fuse_1206_3216Metric
H1, H2, H3, H4: MountingHole_Pad; MountingHole_2.2mm_M2_Pad_Via
J1: USB_C_Receptacle_USB2.0; USB_C_Receptacle_HRO_TYPE-C-31-M-12
J2: ISP; PinHeader_2x03_P2.54mm_Vertical
R1: 330; R_1206_3216Metric
R2, R5: 22; R_1206_3216Metric
R4: 10k; R_1206_3216Metric
SW1, SW2: SW_Push; SW_Cherry_MX_1.00u_Plate
U1: ATmega32U4-AU; TQFP-44_10x10mm_P0.8mm
Y1: 16MHz; Crystal_SMD_HC49-SD

Connections:
+5V: C1.1, C2.1, C3.1, C4.1, D3.3 (VDD), D4.3 (VDD), F1.1, J2.6, R4.1, U1.2 (UVCC), U1.7 (VBUS), U1.14 (VCC), U1.24 (AVCC), U1.34 (VCC), U1.44 (AVCC)
C0: SW1.1, U1.40 (PF1)
C1: SW2.1, U1.39 (PF4)
D+: R2.1, U1.4 (D+)
D-: R5.1, U1.3 (D-)
GND: C1.2, C2.2, C3.2, C4.2, C5.1, C6.1, C7.2, C8.1, D3.1 (VSS), D4.1 (VSS), H1.1, H2.1, H3.1, H4.1, J1.A1 (GND), J1.A12 (GND), J1.B1 (GND), J1.B12 (GND), J1.S1 (SHIELD), J2.4, U1.5 (UGND), U1.15 (GND), U1.23 (GND), U1.33 (~HWB~/PE2), U1.35 (GND), U1.43 (GND)
LED0: R1.1, U1.18 (PD0)
MISO: J2.1, U1.11 (PB3)
MOSI: J2.5, U1.10 (PB2)
unnamed: C5.2, U1.17 (XTAL1), Y1.1
unnamed: C6.2, U1.16 (XTAL2), Y1.2
unnamed: C7.1, U1.42 (AREF)
unnamed: C8.2, U1.6 (UCAP)
unnamed: D1.2 (A), SW1.2
unnamed: D2.2 (A), SW2.2
unnamed: D3.2 (DIN), R1.2
unnamed: D3.4 (DOUT), D4.2 (DIN)
unnamed: F1.2, J1.A4 (VBUS), J1.A9 (VBUS), J1.B4 (VBUS), J1.B9 (VBUS)
unnamed: J1.A6 (D+), J1.B6 (D+), R2.2
unnamed: J1.A7 (D-), J1.B7 (D-), R5.2
R0: D1.1 (K), D2.1 (K), U1.41 (PF0)
RST: J2.3, R4.2, U1.13 (~RESET)
SCK: J2.2, U1.9 (PB1)

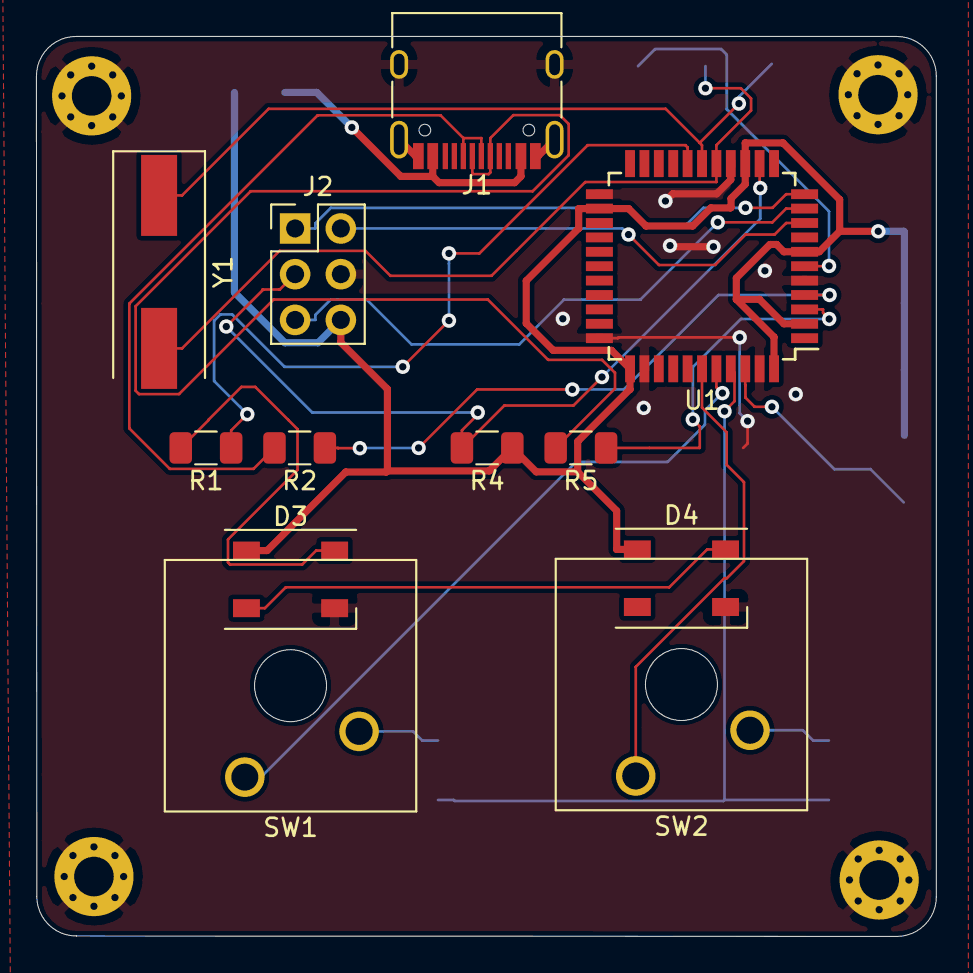
[picture p11: board v0.1/pcb/pcb.kicad_pcb from above]

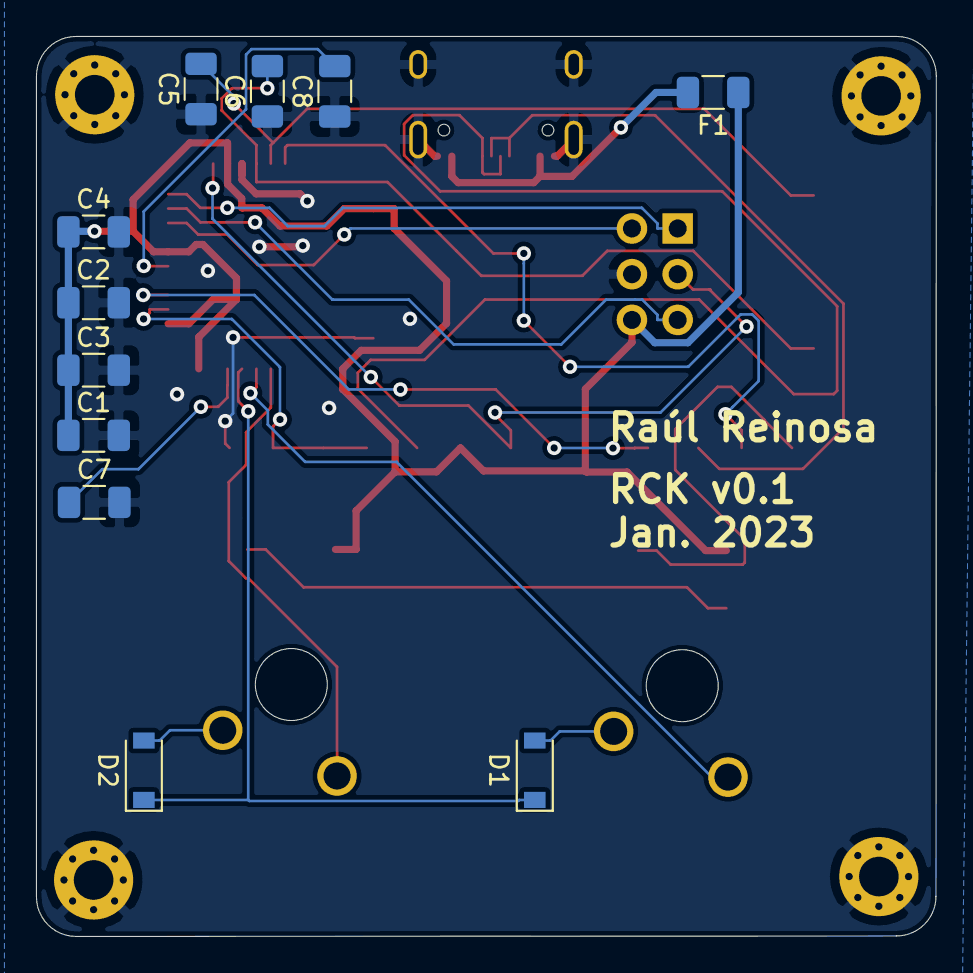
[picture p12: board v0.1/pcb/pcb.kicad_pcb from below]

Board: 2 copper layers, 50.0 x 50.0 mm, 27 parts (11 on the bottom side), 23 nets.
