RReinosa/RCK/(commit log)

2023-01-28 pcb template
    [pcb.kicad_pcb, pcb.sch]
2023-01-28 pcb aggregate submodules
2023-01-28 Add footprint libraries
2023-01-28 creating pcb electronic parts
2023-01-28 fix bug switches
    [pcb.sch]
2023-01-28 add pcb
    [pcb.kicad_pcb]
2023-01-29 add footprint usbC-2.0
2023-01-29 add usbC kicad configuration
    [pcb.sch]
2023-01-29 add matrix switches
    [pcb.sch]
2023-01-29 working on pcb
    [pcb.kicad_pcb, pcb.sch]
2023-01-30 sch done
    [pcb.kicad_pcb, pcb.sch]
2023-01-30 update pcb
    [pcb.kicad_pcb, pcb.sch]
2023-01-31 continue working on pcb
    [pcb.dsn, pcb.kicad_pcb, pcb.sch]
2023-02-01 continue with pcb
    [Budget.xlsx, pcb.dsn, pcb.kicad_pcb, pcb.sch]
2023-02-01 maybe first version
    [pcb.kicad_pcb]
2023-02-02 still working on it
    [pcb.dsn, pcb.kicad_pcb, pcb.sch]
2023-02-02 near to finish pcb
    [pcb-B_Cu.gbr, pcb-B_Mask.gbr, pcb-B_Paste.gbr, pcb-B_SilkS.gbr, pcb-Edge_Cuts.gbr, pcb-F_Cu.gbr, pcb-F_Mask.gbr, pcb-F_Paste.gbr]
2023-02-03 near to have final version pcb ;)
    [pcb.dsn, pcb.kicad_pcb, pcb.sch]
2023-02-07 add test pcb
    [Budget.xlsx, pcb.dsn, pcb.kicad_pcb, pcb.sch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]
2023-02-07 maybe pcb done
    [pcb-B_Cu.gbr, pcb-B_Mask.gbr, pcb-B_SilkS.gbr, pcb-Edge_Cuts.gbr, pcb-F_Cu.gbr, pcb-F_Mask.gbr, pcb-F_SilkS.gbr, pcb-NPTH.drl]
2023-02-07 update budget
    [Budget.xlsx, pcb.sch, test.sch]
2023-02-08 update proyects
    [Budget.xlsx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]
2023-02-08 update progress
    [Budget.xlsx, pcb.kicad_pcb, plate.kicad_pcb, plate.sch]
2023-02-09 starting with software
    [pcb.kicad_pcb]
2023-02-10 first steps with software
    [Budget.xlsx]
2023-02-12 added keyAliases software
    [KeyAliases.xlsx, pcb.kicad_pcb, pcb.sch]
2023-02-21 software changes
    [Budget.xlsx, pcb.kicad_pcb, plate-Edge_Cuts.dxf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]
2023-02-23 updating software features
    [pcb.kicad_pcb, pcb.sch]
2023-02-23 create new gerbers files
    [pcb-B_Cu.gbr, pcb-B_Mask.gbr, pcb-B_Paste.gbr, pcb-B_SilkS.gbr, pcb-Edge_Cuts.gbr, pcb-F_Cu.gbr, pcb-F_Mask.gbr, pcb-F_Paste.gbr]
2023-02-28 fix software issues
    [Budget.xlsx, pcb.kicad_pcb]
2023-03-03 plate done
    [Budget.xlsx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]
2023-03-10 working on plate and software v1.0
    [pcb.dxf, plate.dxf]
2023-10-01 fix: Added last 3d shapes
    [Platecopia.DXF, Stabilizer_Cherry_MX_2.00u.stp, Stabilizer_Cherry_MX_6.25u.stp, pcb.kicad_pcb]
